sentrisense/pivi-hardware/README.md

# PIVI #

This are the Kicad designs files for the PIVI sensor board.
All the code in this repository is licensed Creative Commons

Attribution-NonCommercial-ShareAlike 4.0 International

**Copyright (C) 2014, 2015 LESS Induestries S.A.**

**Author: Sebastian Cerone <sebascerone@lessindustries.com>**
