sentrisense/pivi-hardware/design/BOM_PIVI_2-1.xls

Sheet: Hoja1_2
AC/DC CONVERTER 5V 2A | 1 | 945-2111-5-ND | 5
CAP CER 0.1UF 16V 10% X7R 0603 | 10 | 490-1532-1-ND | 50
CAP CER 0.33UF 16V 10% X7R 0603 | 3 | 445-5126-1-ND | 15
CAP CER 10PF 50V 5% NP0 0603 | 2 | 1276-2154-1-ND | 10
CAP CER 10UF 6.3V 10% X5R 0805 | 8 | 490-3340-1-ND | 40
CAP CER 1UF 6.3V 10% X7R 0603 | 1 | 1276-1024-1-ND | 5
CAP CER 33UF 10V 20% X5R 0805 | 3 | 445-8238-1-ND | 15
CONN FMALE 40POS DL .1" GOLD SMD | 1 | S5729-ND | 5
CONN HEADER 10POS .100 STR TIN | 1 | 609-4710-ND | 5
CONN HEADER 2POS .100 STR TIN | 1 | 5-146285-2-ND | 5
CONN HEADER 3POS .100 STR TIN | 1 | 5-146280-3-ND | 5
CONN HEADER 4POS .100 STR TIN | 1 |  | 5
CONN JACK 3.5MM R/A STEREO SMD | 6 | CP-3503SJCT-ND | 30
CONN TERM BLOCK 2POS 7.5MM 30DEG | 2 | 277-9886-ND | 10
CRYSTAL 32.7680KHZ 7PF SMD | 1 | 728-1065-1-ND | 5
FERRITE CHIP 220 OHM 200MA 0402 | 1 | 490-5190-1-ND | 5
FIXED IND 10UH 150MA 468 MOHM | 1 | 587-2045-1-ND | 5
FIXED IND 1UH 400MA 700 MOHM SMD | 4 | 445-1517-1-ND | 20
FIXED IND 1UH 600MA 150 MOHM SMD | 6 | 445-3163-1-ND | 30
IC MCU 8BIT 128KB FLASH 64TQFP | 1 | ATXMEGA128A3U-AU-ND | 5
IC TLV70233 REG LDO 3.3V 0.3A SOT23-5 | 1 | 296-32415-1-ND | 5
LED CHIPLED BLUE 470NM 0603 SMD | 1 | 475-2816-1-ND | 5
LED RGB W/REFL 3.5X2.8X0.6MM | 1 | 846-1000-2-ND | 5
RES SMD 100 OHM 1% 1/10W 0603 | 3 | 311-100HRCT-ND | 15
RES SMD 10K OHM 1% 1/10W 0603 | 29 | 311-10.0KHRCT-ND | 145
RES SMD 22 OHM 1% 1/10W 0603 | 6 | 311-22.0HRCT-ND | 30
RES SMD 220K OHM 1% 2W 2512 | 9 | A116088CT-ND | 45
RES SMD 270 OHM 1% 1/10W 0603 | 3 | 311-270KHRCT-ND | 15
RES SMD 470 OHM 1% 1/10W 0603 | 1 | 311-470HRCT-ND | 5

Sheet: Hoja1
N° | Description | Designator | Quantity | Value | Package | Manufacture name | Manufacture Part | Distributor Name | Distributor Part | En 50 placas
1 | AC/DC CONVERTER 5V 2A | P3 | 1 | Recom_Power_RAC10-05SC/277 |  | Recom Power | RAC10-05SC/277 | Digikey | 945-2111-5-ND | 23.45156 | 23.45156
2 | CAP CER 0.1UF 16V 10% X7R 0603 | C4, C5, C6, C7, C8, C10, C11, C12, C15, C24, C27 | 11 | 100nF | SMD 0603 | Murata Electronics North America | GRM188R71C104KA01D | DIgikey | 490-1532-1-ND | 0.00600 | 0.06600
3 | CAP CER 0.33UF 16V 10% X7R 0603 | C16, C25, C28 | 3 | 330nF | SMD 0603 | TDK Corporation | C1608X7R1C334K080AC | DigiKey | 445-5126-1-ND | 0.03940 | 0.11820
4 | CAP CER 10PF 50V 5% NP0 0603 | C1, C2 | 2 | 10pF | SMD 0603 | Samsung Electro-Mechanics America, Inc | CL10C100JB8NCNC | Digikey | 1276-2154-1-ND | 0.01380 | 0.02760
5 | CAP CER 10UF 6.3V 10% X5R 0805 | C17, C18, C19, C20, C21, C22 | 6 | 10uF | SMD 0805 | Murata Electronics North America | GRM219R60J106KE19D | Digikey | 490-3340-1-ND | 0.03518 | 0.21108
6 | CAP CER 10UF 6.3V 10% X5R 0603 | C3, C9 | 2 | 10uF | SMD 0603 | Samsung Electro-Mechanics America, Inc | CL10A106KQ8NNNC | Digikey | 1276-1038-1-ND | 0.1925 | 0.38500
7 | CAP CER 1UF 6.3V 10% X7R 0603 | C13 | 1 | 1uF | SMD 0603 | Samsung Electro-Mechanics America, Inc | CL10B105KQ8NNNC | Digikey | 1276-1024-1-ND | 0.01870 | 0.01870
8 | CAP CER 33UF 10V 20% X5R 0805 | C14, C23, C26 | 3 | 33uF | SMD 0805 | TDK Corporation | C2012X5R1A336M125AC | DigiKey | 445-8238-1-ND | 0.60000 | 1.80000
9 | CONN FMALE 40POS DL .1" GOLD SMD | P5 | 1 |  |  | Sullins Connector Solutions | NPPC202KFMS-RC | Digikey | S5729-ND | 3.31180 | 3.31180
10 | CONN HEADER 10POS .100 STR TIN | P1 | 1 |  |  | FCI | 68692-210HLF | Digikey | 609-4710-ND | 0.38600 | 0.38600
11 | CONN HEADER 2POS .100 STR TIN | P2 | 1 |  |  | TE Connectivity AMP Connectors | 5-146285-2 | DigiKey | 5-146285-2-ND | 0.30700 | 0.30700
12 | CONN HEADER 3POS .100 STR TIN | JP1 | 1 |  |  | TE Connectivity AMP Connectors | 5-146280-3 | DigiKey | 5-146280-3-ND | 0.27900 | 0.27900
13 | CONN HEADER 4POS .100 STR TIN | P6 | 1 |  |  | TE Connectivity AMP Connectors |  |  |  | 0.30700 | 0.30700
14 | CONN JACK 3.5MM R/A STEREO SMD | J1, J2, J3, J4, J5, J6 | 6 | JACK_TRS_6PINS |  | CUI Inc | SJ-3503-SMT-TR | DigiKey | CP-3503SJCT-ND | 1.45000 | 8.70000
15 | CONN TERM BLOCK 2POS | P4 | 1 |  |  | Wurth Electronics Inc | 691126710004B | DigiKey | 732-4368-ND | 3.05000 | 3.05000
16 | CRYSTAL 32.7680KHZ 7PF SMD | X1 | 1 | 32.768kHz |  | Seiko Instruments | SSPT7F-7PF20-R | DigiKey | 728-1065-1-ND | 0.47200 | 0.47200
17 | FERRITE CHIP 220 OHM 200MA 0402 | FB1 | 1 | BLM15BB221SN1 | SMD 0402 | Murata Electronics North America | BLM15BB221SN1D | DigiKey | 490-5190-1-ND | 0.05440 | 0.05440
18 | FIXED IND 10UH 150MA 468 MOHM | L2 | 1 | 10uH | SMD 0805 | Taiyo Yuden | LBR2012T100K | Digikey | 587-2045-1-ND | 0.07420 | 0.07420
19 | FIXED IND 1UH 400MA 700 MOHM SMD | L1, L6, L8, L10 | 4 | 1uH | SMD 1210 | TDK Corporation | NLV32T-1R0J-PF | Digikey | 445-1517-1-ND | 0.17520 | 0.70080
20 | FIXED IND 1UH 600MA 150 MOHM SMD | L3, L4, L5, L7, L9, L11 | 6 | 1uH | SMD 0603 | TDK Corporation | MLZ1608A1R0M | Digikey | 445-3163-1-ND | 0.08750 | 0.52500
21 | IC MCU 8BIT 128KB FLASH 64TQFP | IC1 | 1 | ATXMEGA128A3U-A | 64-TQFP (14x14) | Atmel | ATXMEGA128A3U-AU | DigiKey | ATXMEGA128A3U-AU-ND | 3.98520 | 3.98520
22 | IC TLV70233 REG LDO 3.3V 0.3A SOT23-5 | U3 | 1 | TLV70233 | SOT23-5 | Texas Instruments | TLV70233DBVR | Digikey | 296-32415-1-ND | 0.24000 | 0.24000
23 | LED CHIPLED BLUE 470NM 0603 SMD | D1 | 1 | LED | SMD 0603 | OSRAM Opto Semiconductors Inc | LB Q39G-L2N2-35-1 | Digikey | 475-2816-1-ND | 0.11540 | 0.11540
24 | LED RGB W/REFL 3.5X2.8X0.6MM | D2 | 1 | LED_RGB | 6-SMD, Flat Leads | Rohm Semiconductor | SMLV56RGB1W1 | Digikey | 846-1000-2-ND | 0.58560 | 0.58560
25 | RES SMD 100 OHM 1% 1/10W 0603 | R20, R45, R52 | 3 | 100 | SMD 0603 | Yageo | RC0603FR-07100RL | DIgikey | 311-100HRCT-ND | 0.00436 | 0.01308
26 | RES SMD 10K OHM 1% 1/10W 0603 | R2, R3, R4, R5, R10, R11, R12, R13, R14, R15, R19, R21, R22, R24, R25, R27, R28, R30, R31, R33, R34, R36, R37, R39, R40, R44, R46, R47, R51, R53, R54 | 31 | 10k | SMD 0603 | Yageo | RC0603FR-0710KL | DIgikey | 311-10.0KHRCT-ND | 0.00257 | 0.07967
27 | RES SMD 22 OHM 1% 1/10W 0603 | R23, R26, R29, R32, R35, R38 | 6 | 22R | SMD 0603 | Yageo | RC0603FR-0722RL | Digikey | 311-22.0HRCT-ND | 0.00436 | 0.02616
28 | RES SMD 220K OHM 1% 2W 2512 | R16, R17, R18, R41, R42, R43, R48, R49, R50, | 9 | 220k | SMD 2512 | TE Connectivity AMP Connectors | 2176071-6 | Digikey | A116088CT-ND | 0.16858 | 1.51722
29 | RES SMD 270 OHM 1% 1/10W 0603 | R7, R8, R9 | 3 | 270 | SMD 0603 | Yageo | RC0603FR-07270KL | DIgikey | 311-270KHRCT-ND | 0.00570 | 0.01710
30 | RES SMD 470 OHM 1% 1/10W 0603 | R6 | 1 | 470 | SMD 0603 | Yageo | RC0603FR-07470RL | DIgikey | 311-470HRCT-ND | 0.00570 | 0.00570
31 | RES SMD 2,222K OHM 1% 1/10W 0603 | R1 | 1
32 | Pinzas amperometricas seeed |  |  |  |  |  |  |  |  | 11.60000 | 0.00000
 |  |  |  |  |  |  |  |  |  |  | 50.83047
