sentrisense/pivi-hardware/3DModel/audiojack_model/SJ-3503-SMT.stp

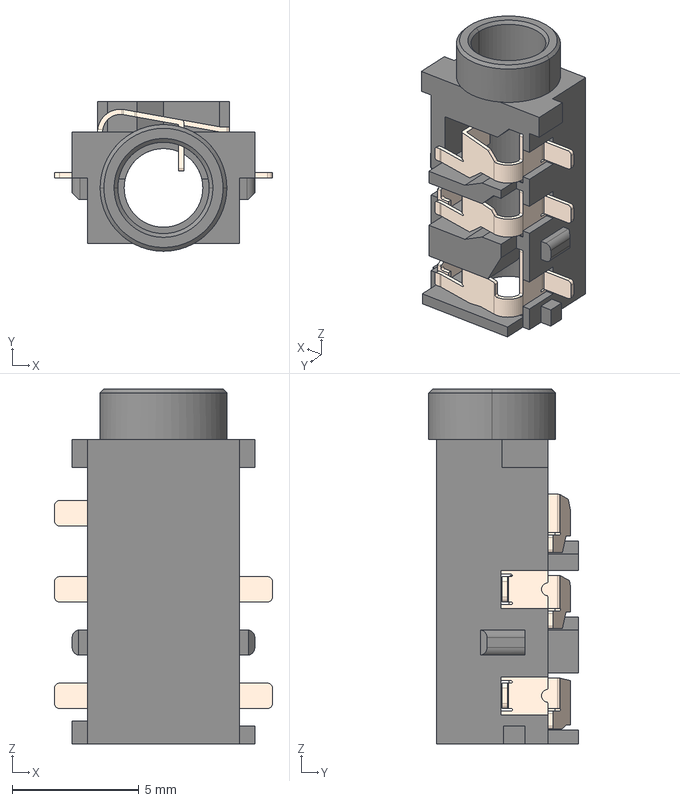
[picture p1: CAD file, 2015-07-29]
3DModel/audiojack_model/SJ-3503-SMT.stp
8.60 x 5.90 x 14.0 mm
