sentrisense/pivi-hardware/3DModel/bornera_model/691414720002B.stp

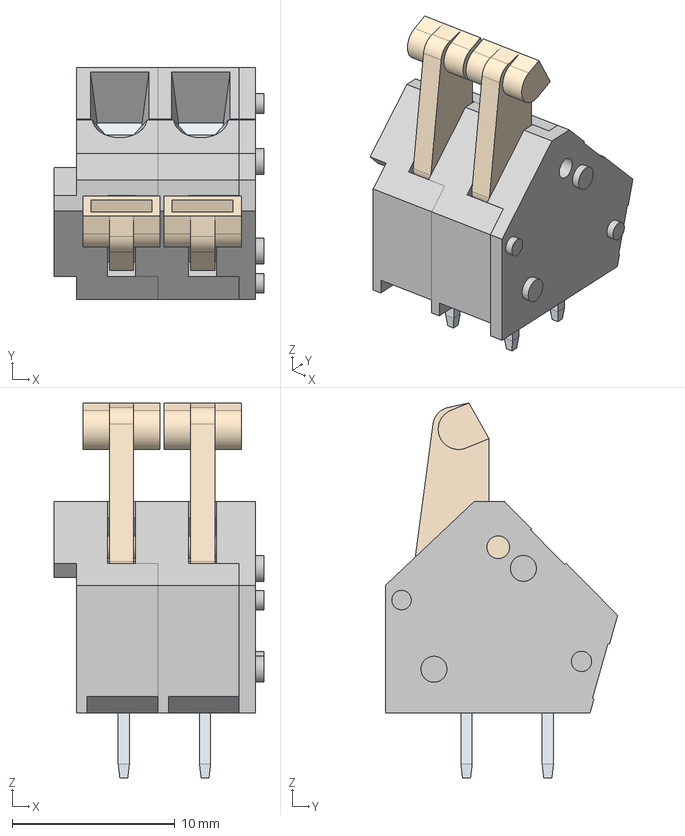
[picture p2: CAD file, 2015-07-29]
3DModel/bornera_model/691414720002B.stp
12.9 x 14.3 x 23.1 mm
6914147200xx_CAPOT
6914147200xx x 2
6914147200xx_LAME x 2
6914147200xx_PIN x 2
6914147200xx_LEVIER x 2
