sentrisense/pivi-hardware/(list of files, cad)

Other CAD files:
3DModel/bornera_model/691414720002B.iges
3DModel/bornera_model/691414720002B.igs
