sentrisense/pivi-hardware/(commit log)

2015-03-05 Initial import of kicad design files
    [ATXMEGA128A3U.sch, analog_front_end.sch, pivi-connectors.sch, pivi-power-supply.sch, pivi-shield.kicad_pcb, pivi-shield.sch, three_circuits.sch]
2015-06-23 Fix #4: add GPIO to reset microcontroller from pi.
    * Add a Raspeberry pi pin (GPIO 18) to reset microcontroller.
    * Add a Raspebeery pi pin (GPIO 23) to control the microcontroller status.
    * Add a RGB LED connected to the microcontroller (PD0, PD1, PD2).
    * Rename all the sheets to PIVI v1.1.
    [ATXMEGA128A3U.sch, analog_front_end.sch, pivi-connectors.sch, pivi-power-supply.sch, pivi-shield.sch, three_circuits.sch]
2015-06-23 Fix #4: Move RGB LED from microcontroller to pi.
    * Move RGB LED. Now it is controlled by the raspberry pi.
    * Change some new libraries for capacitors and resistors.
    [ATXMEGA128A3U.sch, analog_front_end.sch, pivi-connectors.sch, pivi-power-supply.sch, pivi-shield.sch, three_circuits.sch]
2015-07-29 Changing footprints of audio jack3.5mm Added new footprints. Added debub uart, reference voltage Added two extra circuits for voltage measure Moving to PIVI 2.0, added circuits for current clamps
    [691414720002B.iges, 691414720002B.igs, 691414720002B.stp, ATXMEGA128A3U.sch, RGB_LED.sch, SCT-013-000.sch, SJ-3503-SMT.stp, analog_front_end.sch]
2015-07-29 Fix connection problems.
    [measurement_circuits.sch, pivi-connectors.sch, pivi-shield.sch]
2015-07-30 Starting PIVI 2.0 * sch ready. * components in PCB placed.
    [ATXMEGA128A3U.sch, SCT-013-000.sch, current.sch, pivi-connectors.sch, pivi-power-supply.sch, pivi-shield.kicad_pcb, pivi-shield.sch, voltage.sch]
2015-07-30 PCB routed
    [pivi-shield.kicad_pcb]
2015-07-30 PCB routed + BOM complete
    [ATXMEGA128A3U.sch, BOM_PIVI_2-0.xls, SCT-013-000.sch, current.sch, pivi-connectors.sch, pivi-power-supply.sch, pivi-shield.kicad_pcb, voltage.sch]
2015-08-18 Correct RAC10 footprint.
2015-09-13 Fix #10: main route not connected.
    Right now we have the following power labels:
    * +5V from 220v to Raspberry pi and voltage regulator.
    * +3V3 from voltage regulator to microcontroller imput and measurement voltage circuit.
    * +3.3VP DC digital +3.3v (filter to MCU).
    * +3.3VADC DC analog +3.3v
    [ATXMEGA128A3U.sch, SCT-013-000.sch, current.sch, measurement_circuits.sch, pivi-connectors.sch, pivi-power-supply.sch, pivi-shield.sch, voltage.sch]
2015-09-13 Fix #11: Terminal block is not appropriated.
    Changed 2 positions terminal block to a 4 positions terminal block.
    [pivi-connectors.sch]
2015-09-13 Correct minor problem in LED RGB library.
    [pivi-connectors.sch]
2015-09-13 Fix #7, Fix #8, Fix #9, Fix #10, Fix #11
    Several fixes improvements:
    * Fix #7: Add 2mm idle to each side of the connector.
    * Fix #8: Add 0.25mm to each side of the connector.
    * Fix #9: Mirror component. Checked with the datasheet.
    * Fix #10: correct label name.
    * Fix #11: Changed the terminal block for one with a better mouting system.
    Also check the Raspberry pi 20 pin header. It is place in the correct position.
    [ATXMEGA128A3U.sch, SCT-013-000.sch, current.sch, pivi-connectors.sch, pivi-shield.kicad_pcb]
2015-09-13 PIVI 2.1: PCB routed
    [pivi-shield.kicad_pcb]
2015-09-13 Fix #8: connector does not fit in the PCB.
    [pivi-shield.kicad_pcb]
2015-09-14 PIVI version 2.1 routed.
    [ATXMEGA128A3U.sch, SCT-013-000.sch, current.sch, measurement_circuits.sch, pivi-connectors.sch, pivi-power-supply.sch, pivi-shield.dsn, pivi-shield.kicad_pcb]
2015-09-14 Add information to the label.
    [pivi-shield.kicad_pcb]
2015-09-14 Add BOM
    [BOM_PIVI_2-0.xls, BOM_PIVI_2-1.xls]
2015-09-14 Change female 3.5 mm connector.
    Now we have bigger pads to be able to solder the board easily.
    [pivi-shield.kicad_pcb]
