sentrisense/pivi-hardware/(notices)

Notices in the files:
design/current.sch:
Copyright (C) LESS industries S.A. 2014,2015
License: Creative Commons
